kamide-akiyoshi/CAmiDion/schematic/CAmiDion_Core.pdf

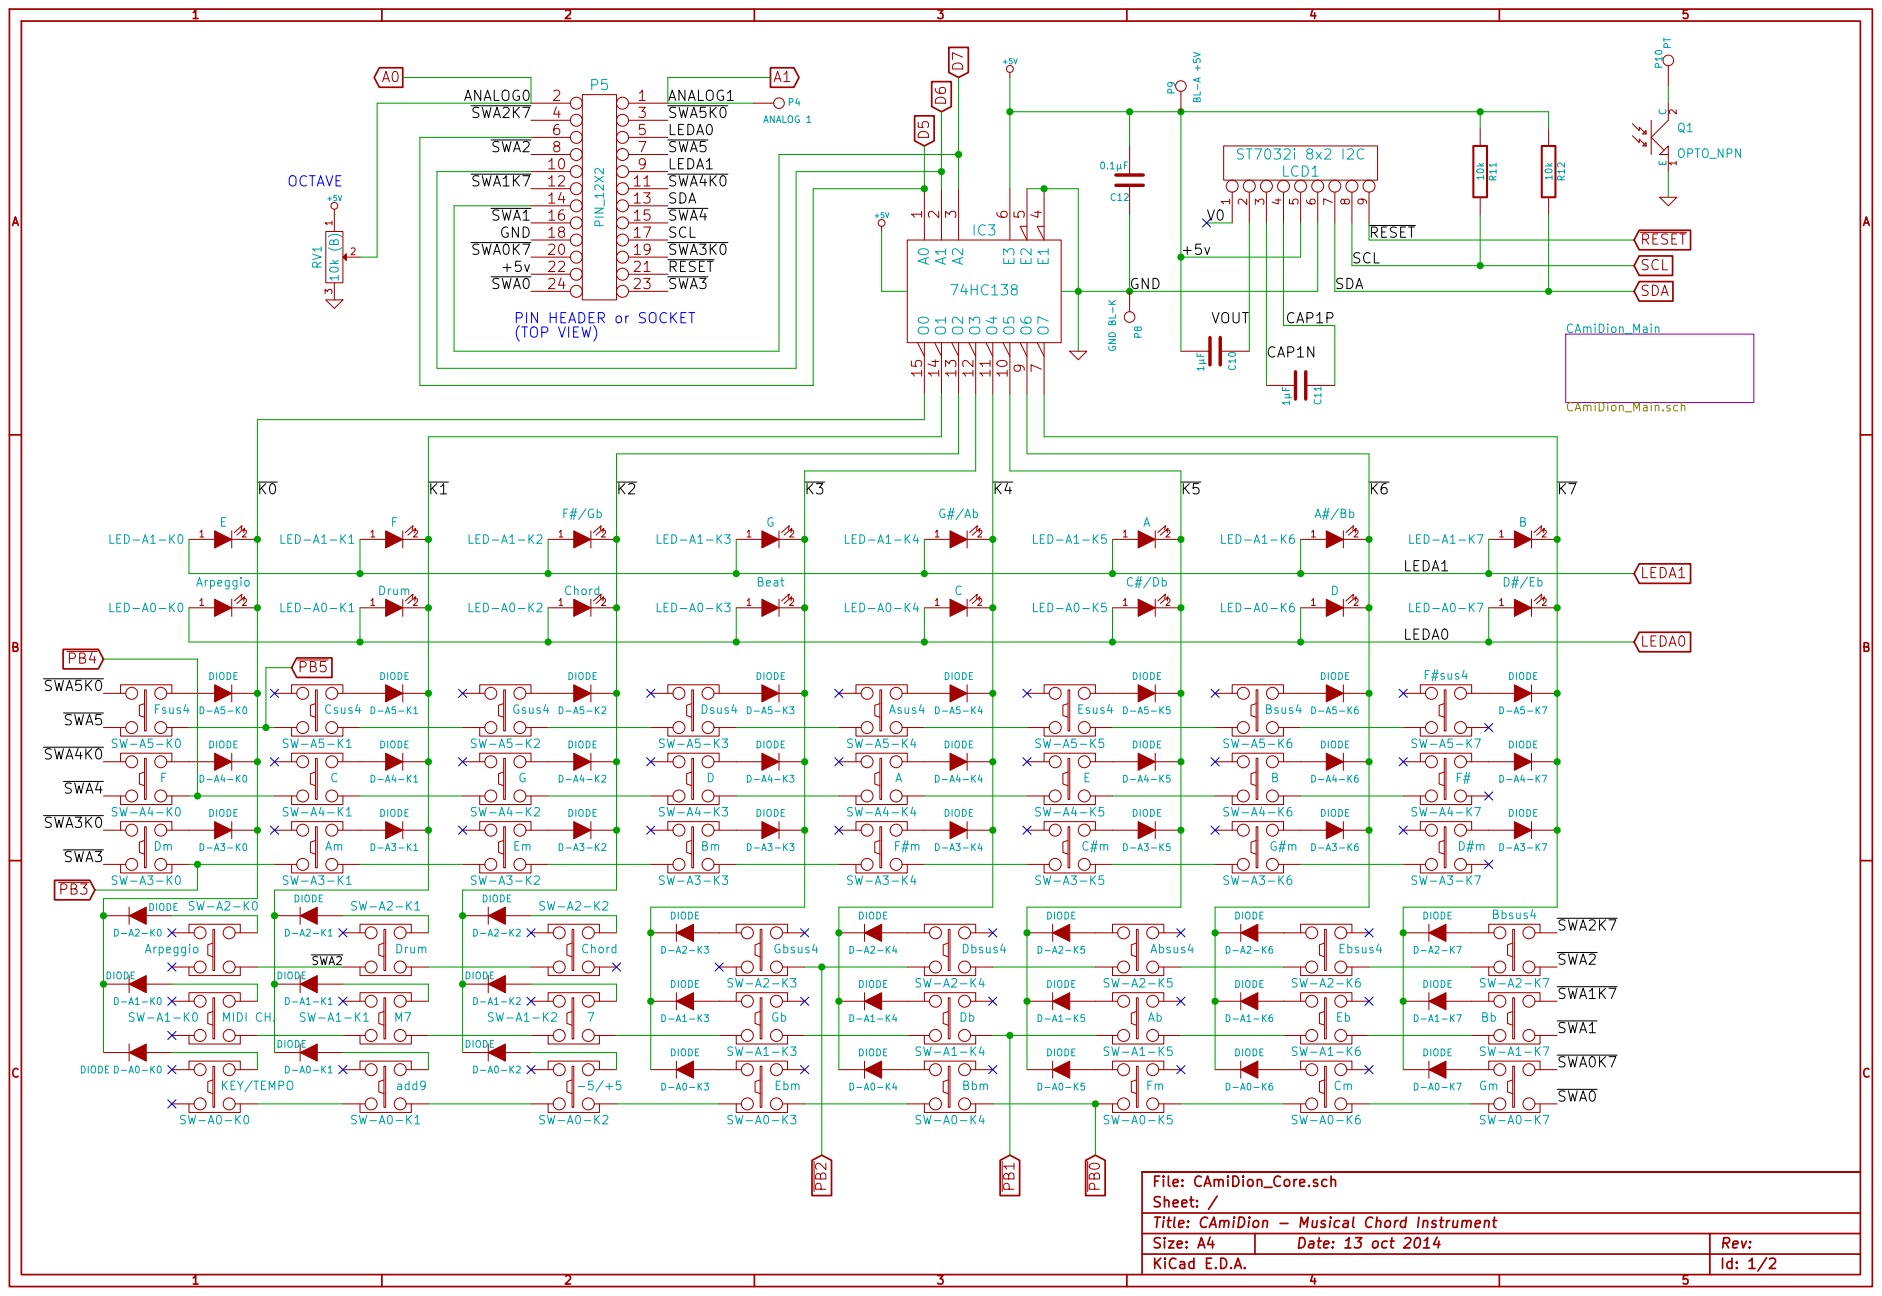
[picture p1: page 1]

D-A5-K1 DIODE SW-A5-K1 Csus4 D-A4-K1 DIODE SW-A4-K1C

D-A5-K2 DIODE SW-A5-K2 Gsus4 D-A4-K2 DIODE SW-A4-K2G

Title: CAmiDion - Musical Chord Instrument

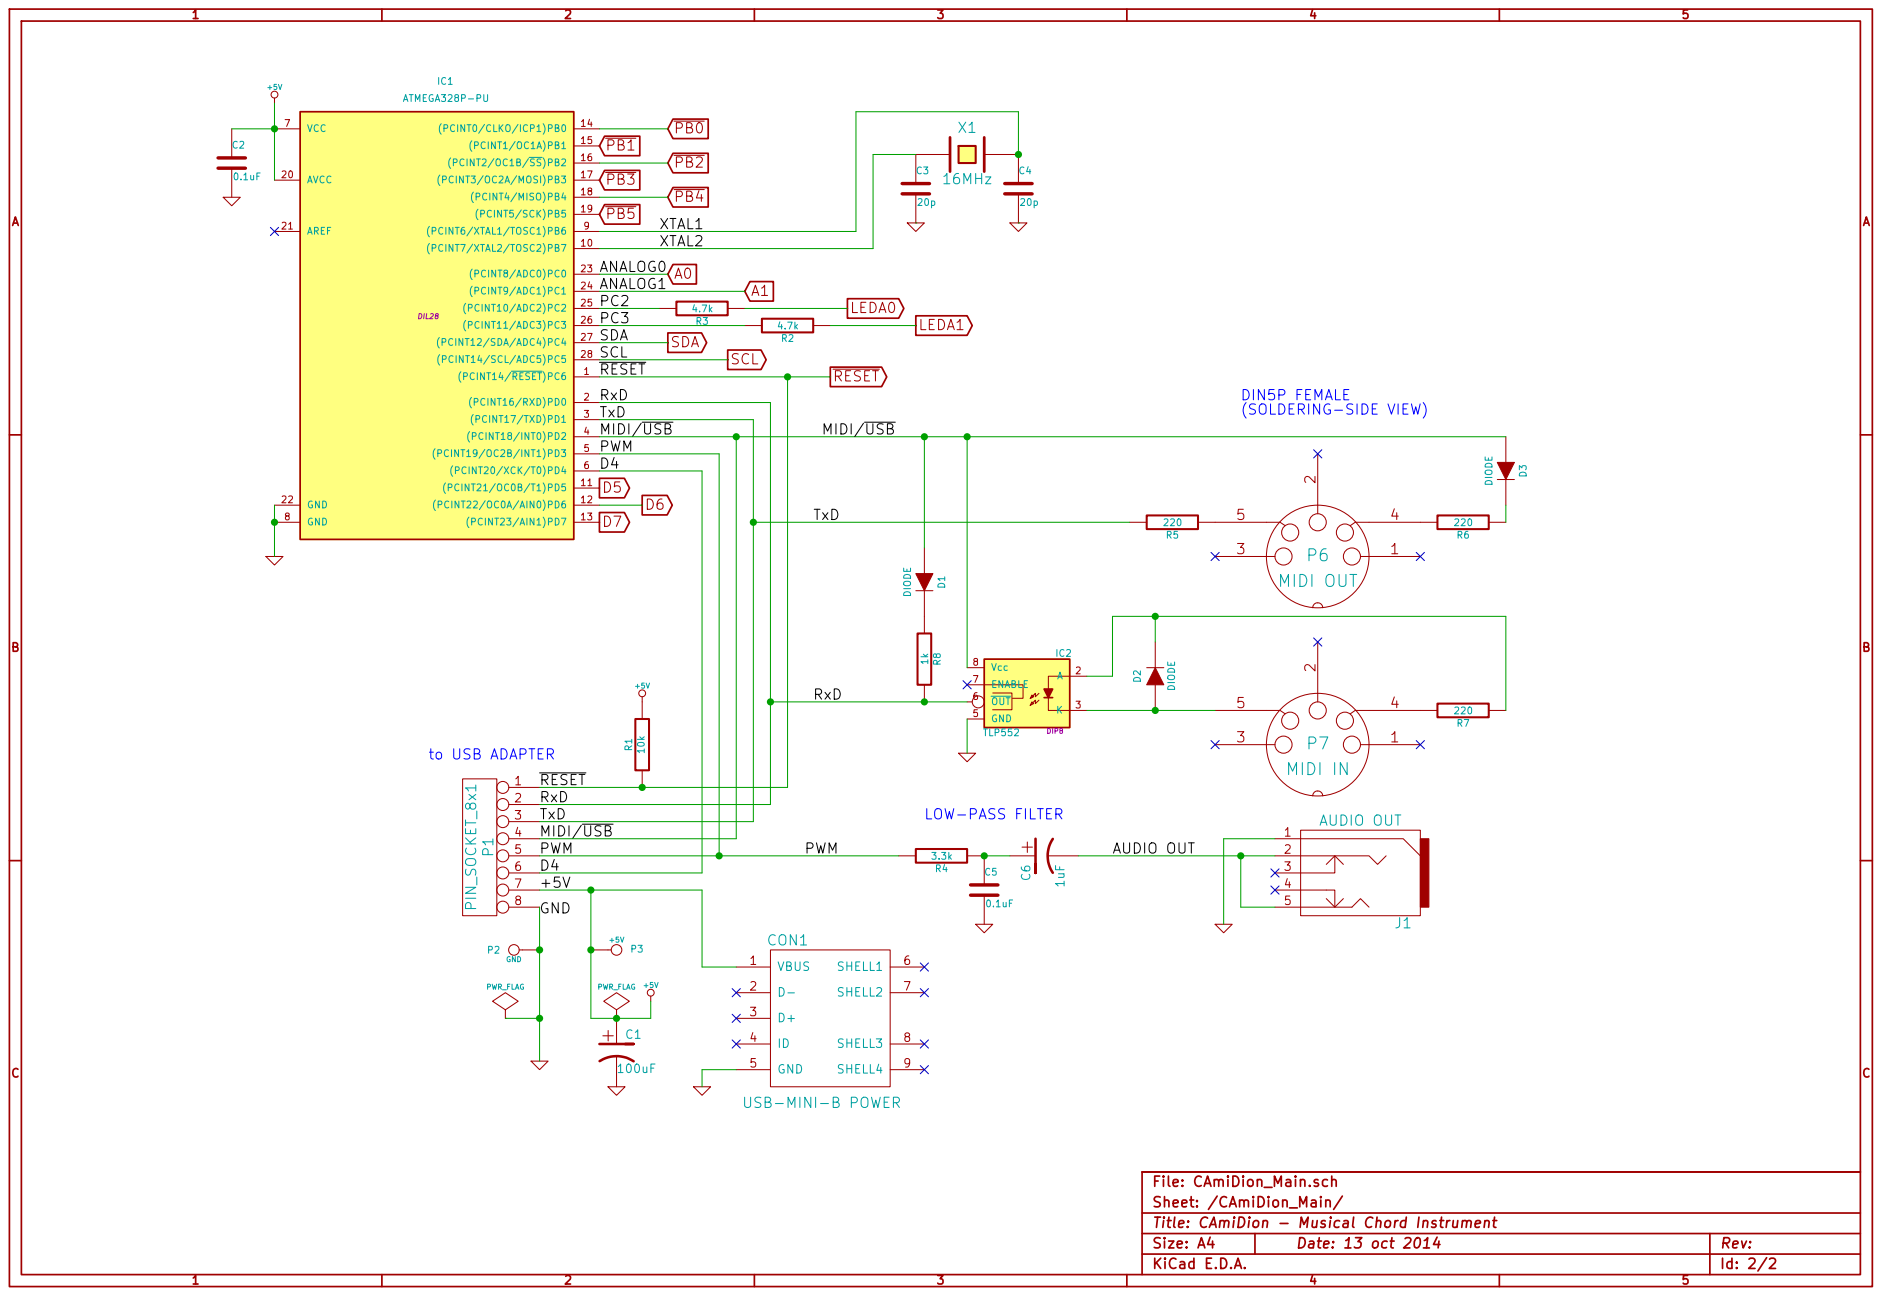
[picture p2: page 2]

File: CAmiDion_Main.sch
Sheet: /CAmiDion_Main/
Title: CAmiDion - Musical Chord Instrument
