kamide-akiyoshi/CAmiDion/schematic/CAmiDion_USB.pdf

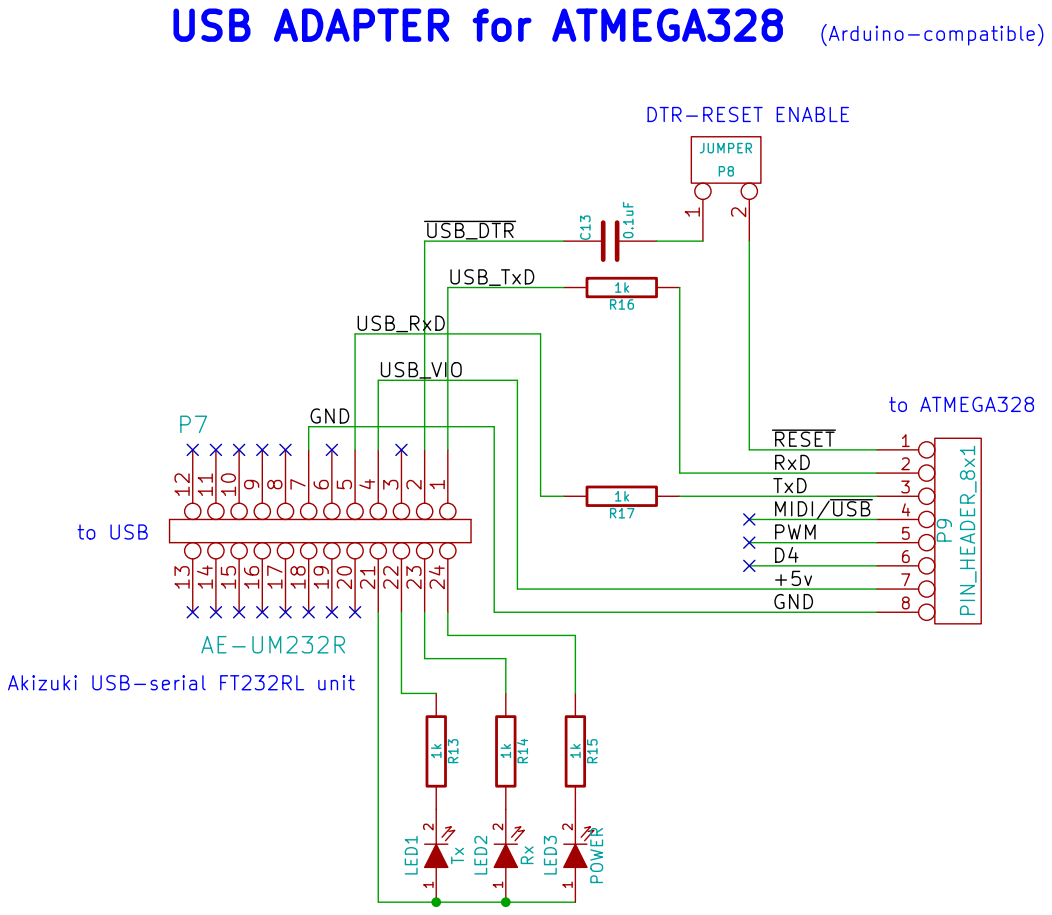
[picture p3: page 1]

Akizuki USB-serial FT232RL unit

File: CAmiDion_USB.sch
Sheet: /
Title: CAmiDion - Musical Chord Instrument
