kamide-akiyoshi/CAmiDion/instruments.ino

PROGMEM const Instrument INSTRUMENTS[] = {
#if defined(OCTAVE_ANALOG_PIN)
// General MIDI instruments
  // Piano
  {sawtoothWavetable, {9, 0, 11, 4}},
  {sawtoothWavetable, {9, 0, 11, 4}},
  {sawtoothWavetable, {9, 0, 11, 4}},
  {sawtoothWavetable, {9, 0, 11, 4}},
  {guitarWavetable, {9, 0, 11, 4}},
  {sawtoothWavetable, {9, 0, 10, 4}},
  {sawtoothWavetable, {9, 0, 11, 4}},
  {sawtoothWavetable, {8, 0, 10, 4}},

  // Chromatic Percussion
  {sawtoothWavetable, {9, 0, 10, 4}},
  {sineWavetable, {9, 0, 11, 4}},
  {sineWavetable, {9, 0, 10, 3}},
  {sineWavetable, {9, 0, 11, 4}},
  {sineWavetable, {8, 0, 8, 4}},
  {sineWavetable, {7, 0, 7, 4}},
  {sawtoothWavetable, {9, 0, 11, 4}},
  {sawtoothWavetable, {9, 0, 9, 4}},

  // Organ
  {guitarWavetable, {9, 255, 11, 4}},
  {sawtoothWavetable, {9, 255, 11, 4}},
  {guitarWavetable, {9, 255, 11, 4}},
  {sawtoothWavetable, {9, 255, 11, 4}},
  {sawtoothWavetable, {9, 255, 11, 6}},
  {sawtoothWavetable, {9, 255, 11, 8}},
  {sawtoothWavetable, {9, 255, 11, 6}},
  {sawtoothWavetable, {9, 255, 11, 6}},

  // Guitar
  {guitarWavetable, {9, 0, 11, 4}},
  {sawtoothWavetable, {9, 0, 11, 4}},
  {guitarWavetable, {9, 0, 11, 4}},
  {sawtoothWavetable, {9, 0, 11, 4}},
  {guitarWavetable, {9, 0, 11, 4}},
  {sawtoothWavetable, {9, 0, 10, 4}},
  {sawtoothWavetable, {9, 0, 11, 4}},
  {randomWavetable, {9, 8, 10, 4}},

  // Bass
  {guitarWavetable, {9, 0, 11, 4}},
  {guitarWavetable, {9, 0, 11, 4}},
  {guitarWavetable, {9, 192, 9, 3}},
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
  {randomWavetable, {10, 64, 12, 12}},
  {sineWavetable, {9, 255, 11, 4}},
  {randomWavetable, {9, 255, 11, 4}},
  {randomWavetable, {9, 255, 11, 12}},
  {randomWavetable, {10, 255, 10, 11}},
  {randomWavetable, {9, 0, 10, 3}},
#else
  {shepardToneSineWavetable, {9, 0, 11, 4}}
#endif
};
