kamide-akiyoshi/CAmiDion/wavetables.ino

//
// Additional Wavetables
//
PROGMEM const byte shepardToneSawtoothWavetable[] = {
0,  6,  6,  12, 6,  12, 12, 18,
5,  11, 11, 18, 11, 17, 17, 24,
5,  11, 11, 17, 11, 17, 17, 23,
11, 17, 17, 23, 17, 23, 23, 29,
5,  11, 11, 17, 11, 17, 17, 23,
11, 17, 17, 23, 17, 23, 23, 29,
11, 17, 17, 23, 17, 23, 23, 29,
16, 23, 23, 29, 22, 29, 29, 35,
4,  10, 10, 16, 10, 16, 16, 22,
10, 16, 16, 22, 16, 22, 22, 28,
10, 16, 16, 22, 16, 22, 22, 28,
16, 22, 22, 28, 22, 28, 28, 34,
9,  15, 15, 22, 15, 21, 21, 28,
15, 21, 21, 27, 21, 27, 27, 33,
15, 21, 21, 27, 21, 27, 27, 33,
21, 27, 27, 33, 27, 33, 33, 39,
3,  9,  9,  15, 9,  15, 15, 21,
8,  15, 15, 21, 14, 21, 21, 27,
8,  14, 14, 20, 14, 20, 20, 26,
14, 20, 20, 26, 20, 26, 26, 32,
8,  14, 14, 20, 14, 20, 20, 26,
14, 20, 20, 26, 20, 26, 26, 32,
14, 20, 20, 26, 20, 26, 26, 32,
20, 26, 26, 32, 26, 32, 32, 38,
7,  13, 13, 19, 13, 19, 19, 25,
13, 19, 19, 25, 19, 25, 25, 31,
13, 19, 19, 25, 19, 25, 25, 31,
19, 25, 25, 31, 25, 31, 31, 37,
12, 19, 19, 25, 18, 25, 25, 31,
18, 24, 24, 30, 24, 30, 30, 36,
18, 24, 24, 30, 24, 30, 30, 36,
24, 30, 30, 36, 30, 36, 36, 42,
};

PROGMEM const byte guitarWavetable[] = {
23, 24, 24, 25, 25, 25, 26, 26,
26, 27, 27, 28, 29, 30, 32, 33,
34, 35, 36, 36, 36, 36, 36, 37,
37, 37, 38, 39, 39, 40, 40, 40,
40, 40, 39, 39, 40, 40, 40, 41,
41, 41, 41, 40, 41, 41, 41, 41,
42, 42, 42, 42, 41, 41, 41, 41,
42, 41, 41, 40, 40, 40, 39, 39,
38, 37, 37, 37, 37, 36, 36, 36,
35, 34, 33, 32, 31, 30, 30, 30,
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
7,  22, 6,  11, 16, 23, 23, 5,
3,  23, 22, 25, 17, 7,  19, 29,
41, 0,  10, 15, 14, 41, 6,  40,
8,  0,  19, 16, 30, 18, 2,  24,
17, 37, 11, 6,  1,  33, 10, 31,
33, 19, 20, 23, 24, 41, 4,  40,
29, 12, 4,  11, 38, 17, 41, 8,
15, 37, 19, 34, 36, 8,  19, 10,
32, 14, 19, 1,  1,  35, 35, 3,
};
