kamide-akiyoshi/CAmiDion/(commit log)

2015-01-02 バージョン20141209のGitによるバージョン管理を開始
2015-01-27 ファイル名を変更（Arduino IDEで扱うにはinoと同じディレクトリ名にする必要があったため）
2015-03-08 Arduino 1.6.0 でコンパイルエラーが出る問題の修正
2015-05-03 アルカリ電池(1.5v) x 3 用で使う場合のLCDパラメータをコメントアウトした状態で追加
2015-08-29 ・チャタリング回避機能を新たに実装し、タクトスイッチ劣化による影響を軽減した。 ・ソースファイルを分割、リファクタリングし、液晶や電源などのコンフィギュレーション用 #define を CAmiDionConfig.h に分離した。
2015-08-30 E♭/Cmで暴走するバグを修正。 チャタリング待ち時間配列の要素計算誤りが原因で、E♭sus4/E♭/Cmを押すと配列をはみ出しプログラムが暴走する現象が発生していた。
2015-09-06 リファクタリング
2015-09-07 リファクタリング: ボタン情報を一元化することによりRAM/フラッシュのサイズを減らした
2015-09-09 リファクタリング(ボタン処理まわりの整理など)
2015-09-12 ・リズム音をMIDI OUTにも出力するようにした ・ベロシティ、リズム音を定義する #define エントリを CAmiDionConfig.hに 追加 ・リファクタリング
2015-09-13 PWMDAC_Synthのバージョンアップに伴い、新たに再定義可能になった#defineを追加
2015-09-14 PWMDAC_Synthのupdate()が新設されたことに伴う修正
2015-09-15 最新のPWMDAC_Synthに合わせて修正 ＆ ソースの整理など
2015-09-16 最新版のPWMDAC_Synthに合わせた修正
2015-09-17 limits.hをPWMDAC_Synth.hへ移動
2015-09-20 PWMDAC_Synthの波形表生成マクロ化最新版に対応
2015-09-20 ADSR初期値をインスタンス生成時に設定（新しいPWMDAC_Synthに対応）
2015-09-21 ・チャタリング防止用パラメータをCAmiDionConfig.hに外出し ・LedStatusクラス体系の整理など
2015-09-26 PWMDAC_Synthのエンベロープパラメータ形式変更に対応
2015-09-29 WaveSelecterクラスのチューニング
2015-10-02 リファクタリング：enum ButtonID の外出しなど
2015-10-03 ・PWMDAC_Synthエンベロープパラメータ形式の変更に対応 ・リファクタリング
2016-03-16 ・デフォルトADSRエンベロープのDecayとReleaseを1ステップ伸ばした ・74HC138デコーダ⇔LEDビューポート間のインターフェース見直し ・MIDI.read()の呼び出し頻度を最大化してMIDI IN取りこぼし問題を改善
2016-03-17 LED off時にアノード側ポートをHi-Z(ハイインピーダンス)にすることを優先するよう修正
2016-04-21 ・MIDI IN からのProgramChangeに対応 ・PWMDAC_Synth呼び出しインターフェース変更（Instrument構造体）に対応 ・Instrument構造体で音色テーブルをとりあえず実装
2016-04-22 ・波形選択用WaveSelecterクラスの一新（前日版には*(swi)++のかっこを忘れるバグがあったが、select_wave_indices配列自体を廃止する処理方式に置き換える ことで解決） ・音色データをinstruments.inoに分離 ・打楽器用MIDIチャンネル番号の定義名をCAmiDionConfig.hに分離
2016-04-23 [BUGFIX] 波形を先頭から戻って最後に行こうとすると文字化けするバグの修正 音色テーブルのチューニング CAmiDionConfig.hの誤記修正
    [CAmiDion.ino, CAmiDionConfig.h, instruments.ino]
2016-04-23 リセット機能に下記を追加 ・消灯しなくなったLEDをまとめて消灯 ・ドラム音色再設定 ・SysEx の GM SYSTEM ON によるリセット
2016-04-24 GS、XGのシステムリセットを有効化
2016-04-27 ・MIDI同期（スレーブ）機能を実装（24/Q の Clock が MIDI IN に来たらテンポを同期） ・メトロノーム周りを中心にリファクタリング
2016-04-29 MIDI同期処理周りを中心にリファクタリング
2020-04-05 Supported the compilation on Arduino IDE on Linux
    - Refectored, and "const" added
    - Update against performance-down when compiled on Linux
    - Moved some functions from PWMDAC_Synth
2020-04-18 Keybind swapped for MIDI program-change
    [CAmiDion.ino]
2023-08-15 Update README.md - Typo fixed (URL of PWMDAC_Synth)
2023-11-19 Add schematic PDF
